dpkliem/wro-2022/dokumentation/Heckansicht.jpg

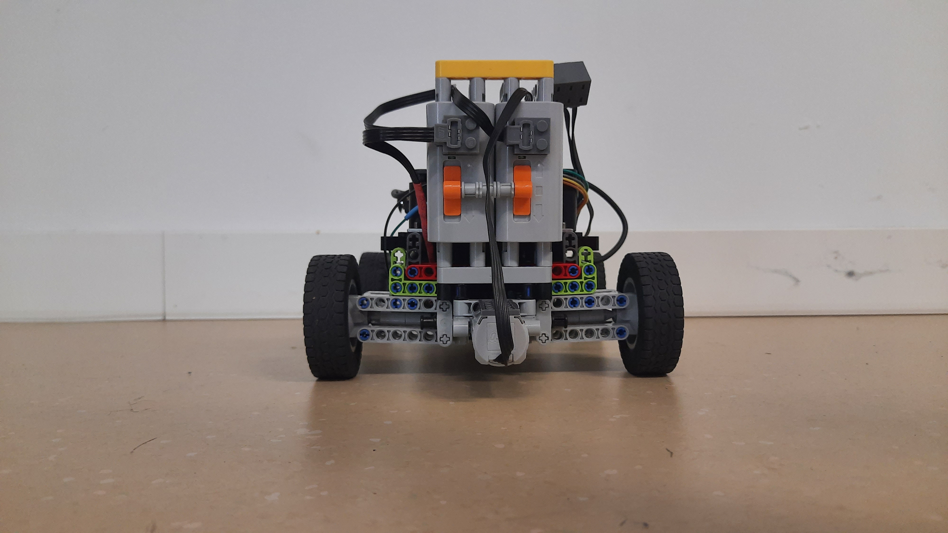
dokumentation/Heckansicht.jpg
