dpkliem/wro-2022/dokumentation/Seitenansicht_von_rechts_updated.jpeg

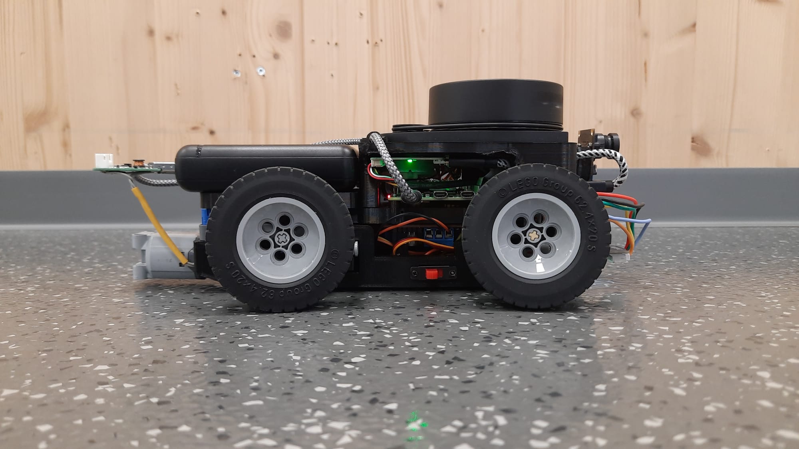
dokumentation/Seitenansicht_von_rechts_updated.jpeg
