dpkliem/wro-2022/README.md

Documentation
World Robot Olympiad – Future Engineers
Team Siemens Chemnitz
Bei YouTube haben wir eine nicht gelistete Playlist erstellt. Darin ist ein Video, in dem unser Auto das Eröffnungsrennen fährt und ein Video, in dem unser Auto das Hindernisrennen meistert, enthalten. Hier geht es zu Playlist: https://youtube.com/playlist?list=PLosNMtmjerQhduPas9dO_IPUJpvwRk50k.
Als Kleincomputer verwenden wir einen Raspberry Pi 4B. An diesem ist die gesamte Sensorik (Kamera, Schalter und Farbsensor) und Aktorik (Servomotor und Antriebsmotor mit Motortreiber) angeschlossen. Der Raspberry Pi wird über eine Powerbank mit 5V Betriebsspannung versorgt. Die Sensorik bezieht ihre Spannung vom Raspberry Pi. Der Servomotor hat eine eigene Spannungsversorgung von 6V. Der Antriebsmotor hat ebenfalls eine eigene Spannungsversorgung von 9V. Um den Antriebsmotor anzusteuern, befindet sich zwischen Raspberry Pi und Antriebsmotor ein Motortreiber.
Einrichtung des Raspberry Pi’s: Zuerst wird auf dem Kleincomputer das Betriebssystem Debian Buster installiert. Dies wird von einem externen Computer auf die SD-Karte des Kleincomputers geschrieben. Um weitere Schritte durchzuführen, verbindet man den Raspberry Pi über ein WLAN-Netzwerk mit einem externen Computer. Dazu greift man mittels dem Programm 'Remotedesktopverbindung' (unter Windows) von einem externen Computer auf den Kleincomputer zu. Alternativ kann der Raspberry Pi auch über HDMI Kabel mit einem Monitor verbunden werden, dann muss allerdings noch Maus und Tastatur an die USB-Ports des Kleincomputers angeschlossen werden. Jetzt muss in den Einstellungen der Kamerazugriff erlaubt werden. Da wir in unserem Programm auf Bibliotheken zurückgreifen, müssen diese jetzt installiert werden, um unser Programm nutzen zu können. Es muss 'OpenCV' installiert werden, eine genauere Anleitung findet man unter folgendem Link: https://singleboardbytes.com/647/install-opencv-raspberry-pi-4.html. Des Weiteren muss die Bibliothek 'gpiozero' installiert werden. Eine genauere Anleitung findet man unter folgendem Link: https://gpiozero.readthedocs.io/en/stable/installing.html. Außerdem muss auch noch die Bibliothek 'NumPy' aufgespielt werden, sowie die Bibliothek 'pigpio'. Hilfestellungen hierzu erhält man unter folgenden beiden Links: https://numpy.org/install/ und https://abyz.me.uk/rpi/pigpio/download.html. Zuletzt muss noch die Bibliothek 'Adafruit TCS34725 Library' installiert werden um den Farbsensor nutzen zu können. Die Anleitung findet sich unter folgendem Link: https://learn.adafruit.com/adafruit-color-sensors/python-. Der Code kann nun in einer frei gewählten Programmierumgebung (wir nutzen VisualStudioCode) auf dem Raspberry Pi geöffnet und bearbeitet werden. Wenn man nun ausführen auswählt, wird der Code auf dem Steuergerät kompiliert und ausgeführt. Ein Hochladen entfällt, da direkt auf dem Steuergerät programmiert wird. 
Zum Code: Unser Programm startet, wenn zwei Kontakte mit einem Schalter verbunden werden. Nun wird der Motor gestartet. Jetzt nimmt die Kamera ein Frame auf. Dieses dreht nun unsere Software und schneidet die obere Hälfte weg. Nun wird das Bild in ein HSV-Farbmodell umgewandelt. Über eine Funktion werden jetzt drei Bilder erstellt. Daher enthält das erste alle schwarzen, das zweite alle grünen und das letzte alle roten Flächen. Nun erkennt eine Funktion die untere Kante der Begrenzungen. Eine weitere Funktion erkennt die roten und grünen Objekte. Aus den erkannten Linien und Objekten wird nun die ideale Fahrtrichtung errechnet. Daraus wird der einzuschlagende Winkel des Servos errechnet und an diesen ausgegeben. Der Farbsensor detektiert nun die orange oder blaue Linie und zählt darüber die Runden. Nachdem er die dritte Runde gezählt hat, hält er nach einer gewissen Zeit (maximal 6 Sekunden) an.

UPDATE zum Deutschlandfinale:

Aufgrund der mangelnden Wendigkeit, die sich im regionalen Ausschied gezeigt hatte, wurde das Roboterauto von Grund auf erneuert. Um den Wendekreis zu verkleinern kann das Roboterauto nun mit beiden Achsen lenken. Die Lenkkonstruktion wurde hauptsächlich mit Lego umgesetzt. Um zusätzlich noch das Gewicht und die Abmaße des Roboterautos zu optimieren, ist der Großteil der konstruktiven Komponenten des Roboters mittels eines 3D-Druckers gedruckt wurden. Bei Fragen zu Material und Druckeinstellungen geben wir auf Nachfrage gerne Antwort. Die Dateien der einzelnen Bauteile befinden sich im entsprechenden Ordner. Zusätzlich wurde noch ein 3D-Modell des Roboters erstellt, welches jedoch aufgrund der Dateigröße nicht ins Repository hochgeladen werden konnte, auf Nachfrage aber zur Verfügung gestellt werden kann. Weiterhin wurde die Spannungsversorgung verbessert. Die drei Spannungsversorgungen, die im regionalen Ausscheid verwendet wurden, konnten mittels eines Step-up Converters, der die 5 Volt Ausgangsspannung der Powerbank in 12 Volt für den Motortreiber und den Motor umwandelt, auf eine einzige Spannungsversorgung reduziert werden. Die beiden vorher verwendeten Motoren wurden durch einen stärkeren Lego-Motor ersetzt. Ein weiteres Upgrade ist der Lidarsensor, welcher die Probleme mit der Lichtabhängigkeit des Bildverarbeitungsalgorithmus ausgleichen soll. Der Sensor erfasst in 360° alle Objekte, an denen der Laserstrahl reflektiert wird, und gibt die Polarkoordinaten bezüglich des Lidarsensors und die Distanz zurück. Das Konzept für den Algorithmus ist ähnlich dem Algorithmus für die Bildverarbeitung. Die Punktwolke, die der Lidarsensor ausgibt, wird durch den Algorithmus auf die Begrenzungslinien hin analysiert. Anhand der Neigung und der Lage der der Begrenzungen wird der Winkel für den Servo berechnet. Jedoch wird der Lidarsensor im Wettbewerb nicht verwendet, da aufgrund der kürze  der Zeit das Programm nicht ausreichend getestet und erprobt werden konnte.
