dpkliem/wro-2022/dokumentation/WRO_2022_Technische_Zeichnung.pdf

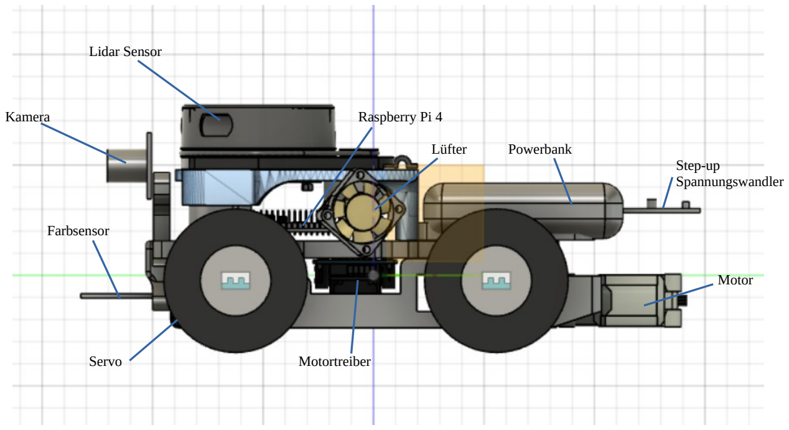
[picture p3: page 1]

Lidar Sensor

Kamera | Raspberry Pi 4
Lüfter | Powerbank
Step-up
Spannungswandler

Farbsensor

Motor

Servo | Motortreiber
