dpkliem/wro-2022/dokumentation/Ansicht_von_unten.jpg

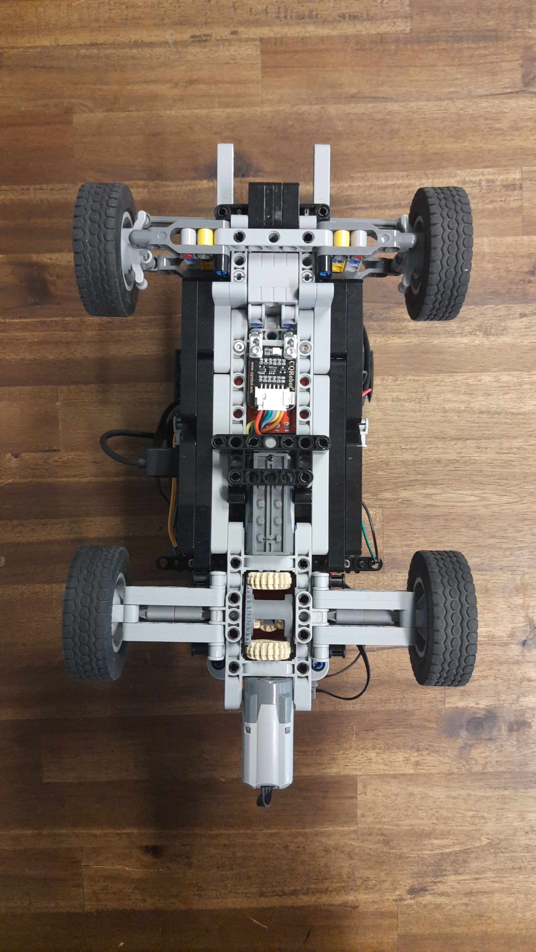
dokumentation/Ansicht_von_unten.jpg
