dpkliem/wro-2022/dokumentation/Ansicht_von_unten_updated.jpeg

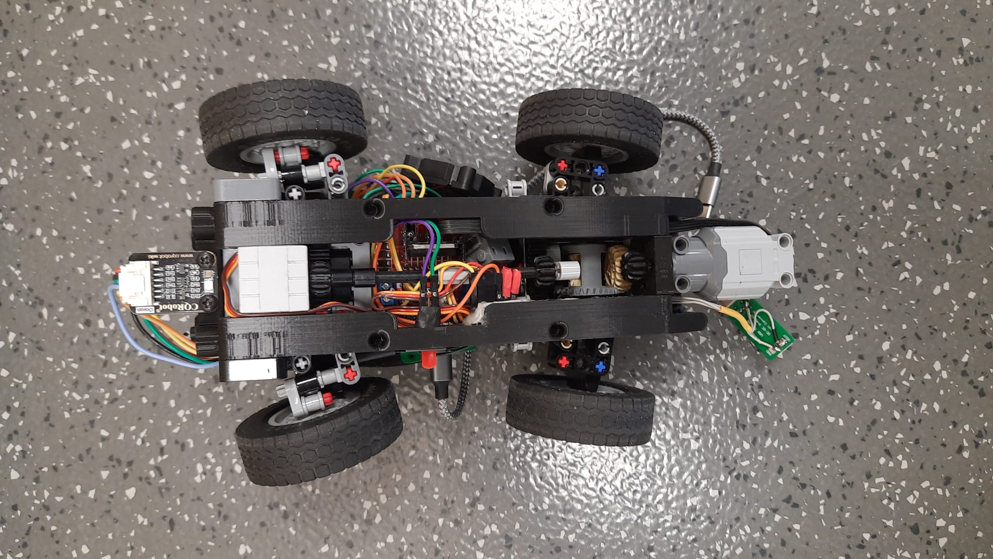
dokumentation/Ansicht_von_unten_updated.jpeg
