dpkliem/wro-2022/dokumentation/Draufsicht.jpg

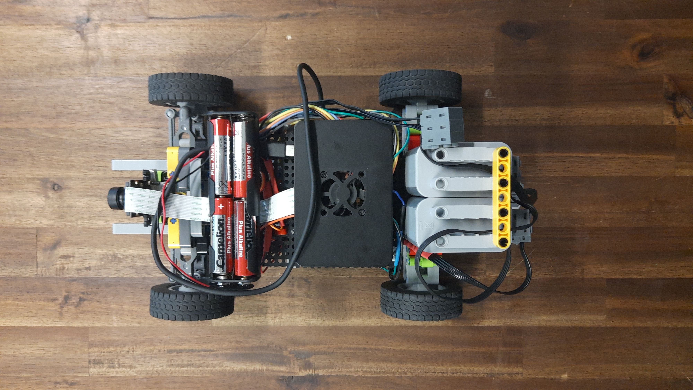
dokumentation/Draufsicht.jpg
