dpkliem/wro-2022/dokumentation/Draufsicht_updated.jpeg

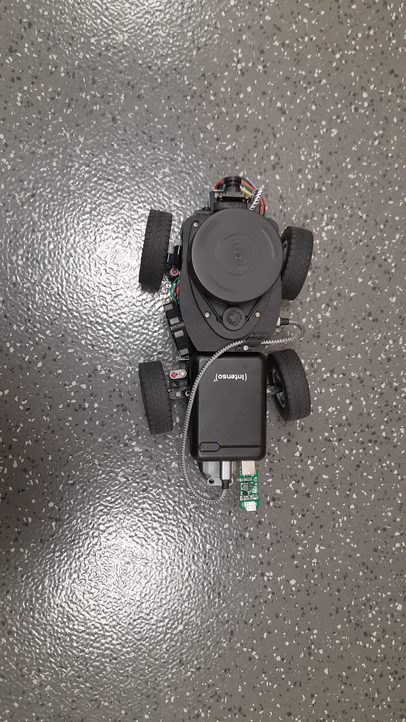
dokumentation/Draufsicht_updated.jpeg
