dpkliem/wro-2022/dokumentation/Frontansicht.jpg

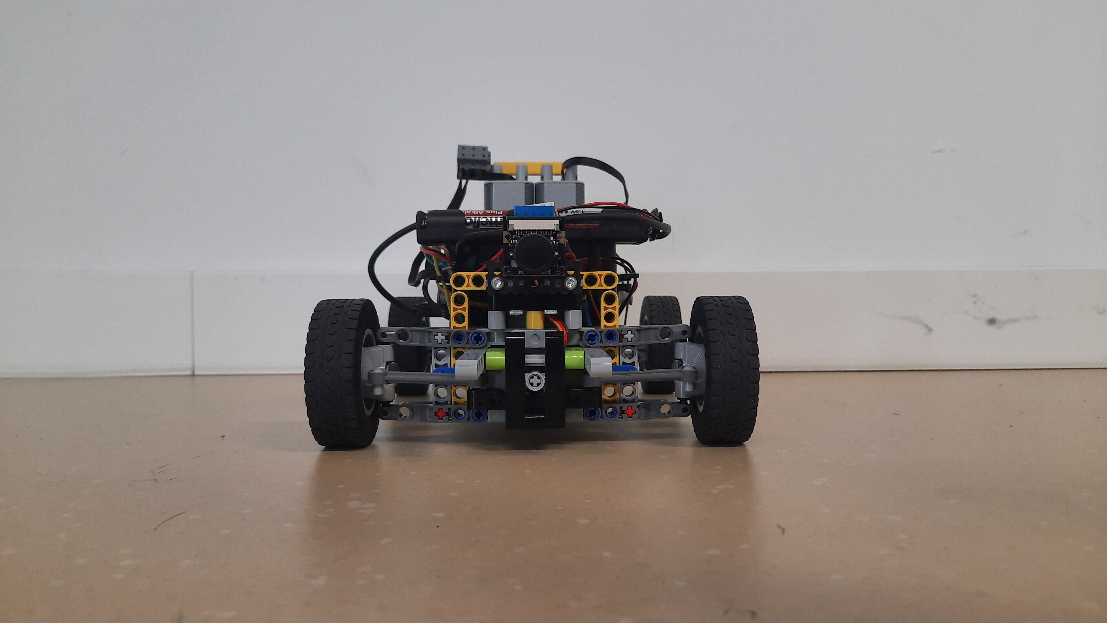
dokumentation/Frontansicht.jpg
