dpkliem/wro-2022/dokumentation/Frontansicht_updated.jpeg

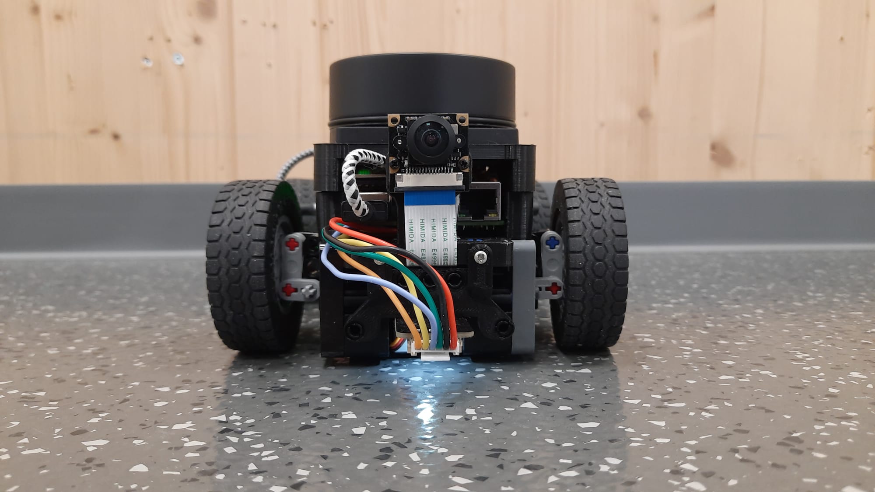
dokumentation/Frontansicht_updated.jpeg
