dpkliem/wro-2022/dokumentation/Heckansicht_updated.jpeg

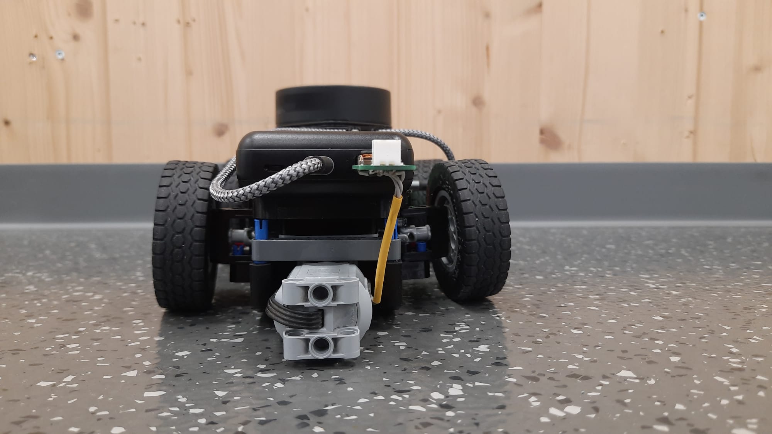
dokumentation/Heckansicht_updated.jpeg
