dpkliem/wro-2022/dokumentation/Seitenansicht_von_links.jpg

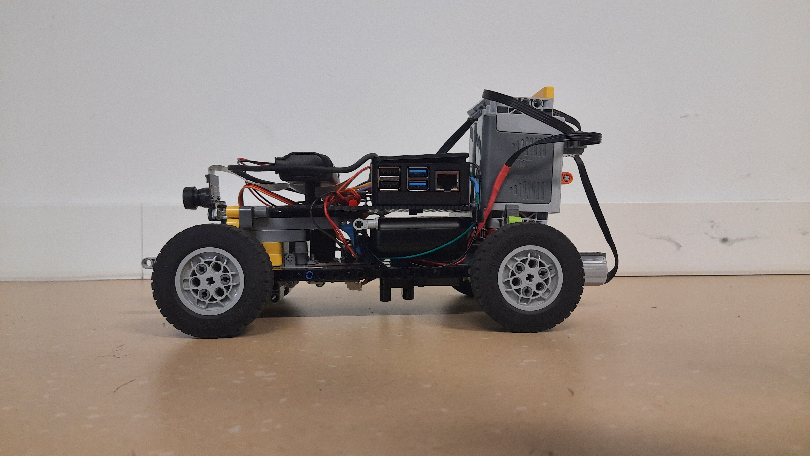
dokumentation/Seitenansicht_von_links.jpg
