dpkliem/wro-2022/dokumentation/Seitenansicht_von_links_updated.jpeg

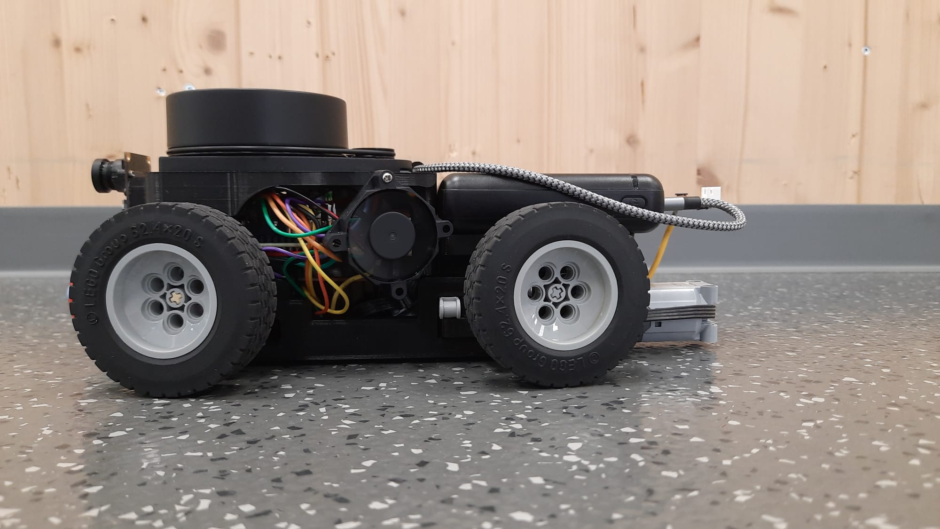
dokumentation/Seitenansicht_von_links_updated.jpeg
