dpkliem/wro-2022/dokumentation/Seitenansicht_von_rechts.jpg

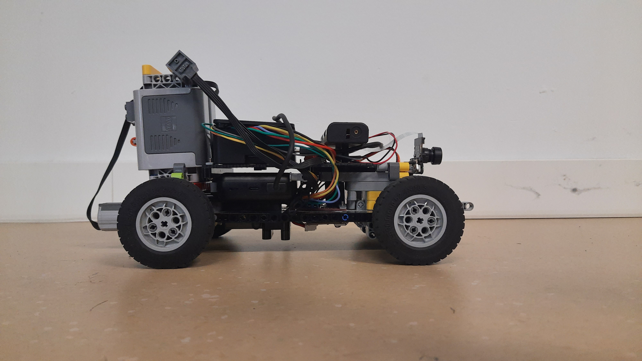
dokumentation/Seitenansicht_von_rechts.jpg
