dpkliem/wro-2022/3d_dateien/Motorhalterung.stl

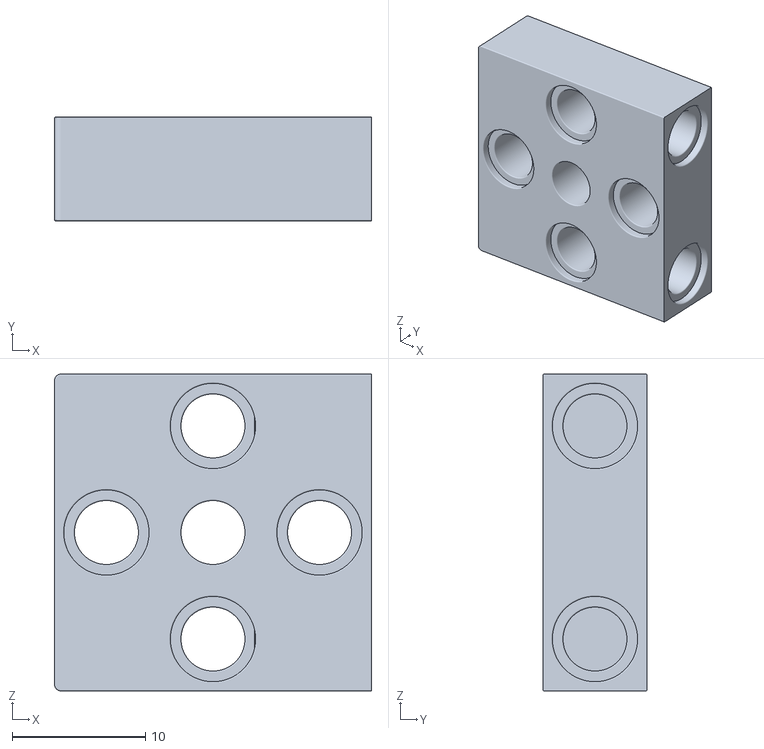
[picture p14: CAD file, 2022-09-13]
3d_dateien/Motorhalterung.stl
23.8 x 7.80 x 23.8
