dpkliem/wro-2022/3d_dateien/Träger Schalter.stl

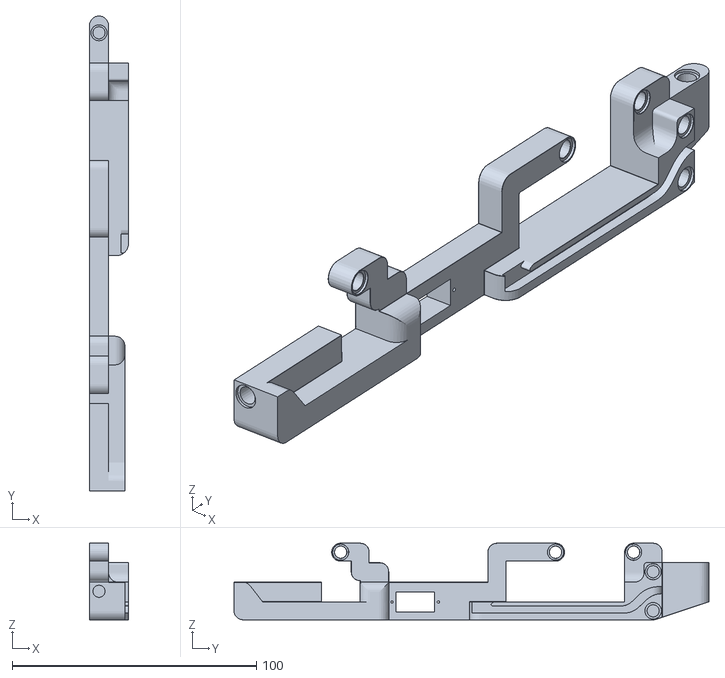
[picture p15: CAD file, 2022-09-13]
3d_dateien/Träger Schalter.stl
16.0 x 194.6 x 31.4
