dpkliem/wro-2022/3d_dateien/Kabelklemme.stl

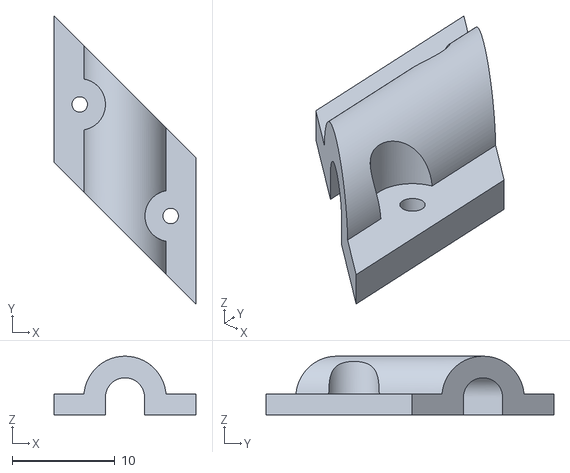
[picture p17: CAD file, 2022-09-13]
3d_dateien/Kabelklemme.stl
13.8 x 28.0 x 5.70
