dpkliem/wro-2022/3d_dateien/Lidarhalterung neu.stl

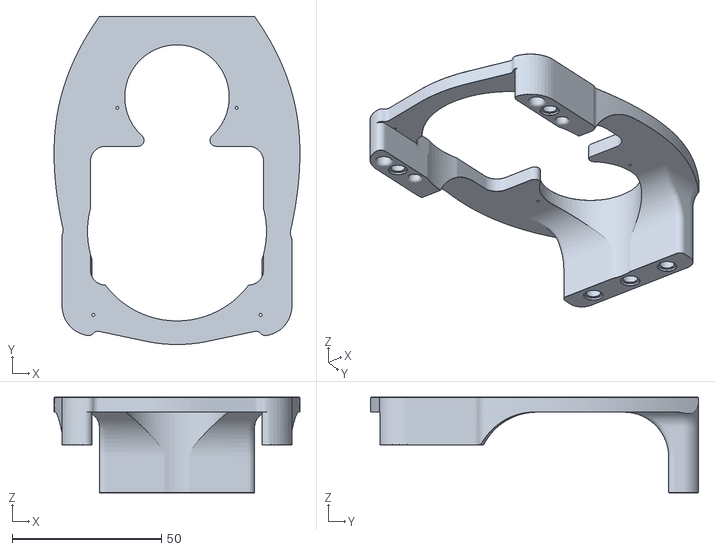
[picture p18: CAD file, 2022-09-13]
3d_dateien/Lidarhalterung neu.stl
82.4 x 109.9 x 32.0
