dpkliem/wro-2022/3d_dateien/Farbsensorhalterung.stl

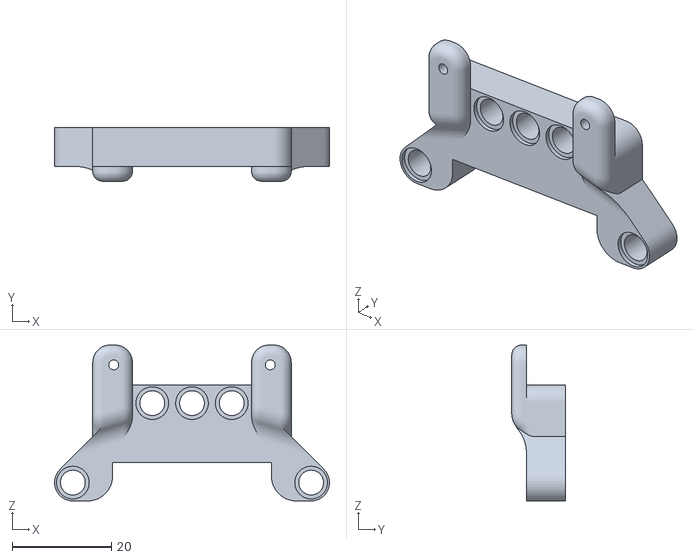
[picture p19: CAD file, 2022-09-13]
3d_dateien/Farbsensorhalterung.stl
55.4 x 10.8 x 31.4
