dpkliem/wro-2022/3d_dateien/Halterung Powerbank.stl

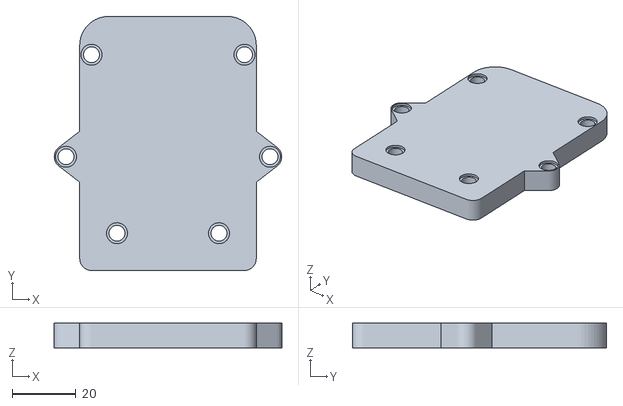
[picture p20: CAD file, 2022-09-13]
3d_dateien/Halterung Powerbank.stl
71.4 x 79.7 x 7.80
