dpkliem/wro-2022/dokumentation/WRO_2022_Schaltplan_updated.pdf

1 | 2 | 3 | 4 | 5 | 6 | 7 | 8 | 9 | 10 | 11 | 12 | 13 | 14 | 15 | 16 | 17

A

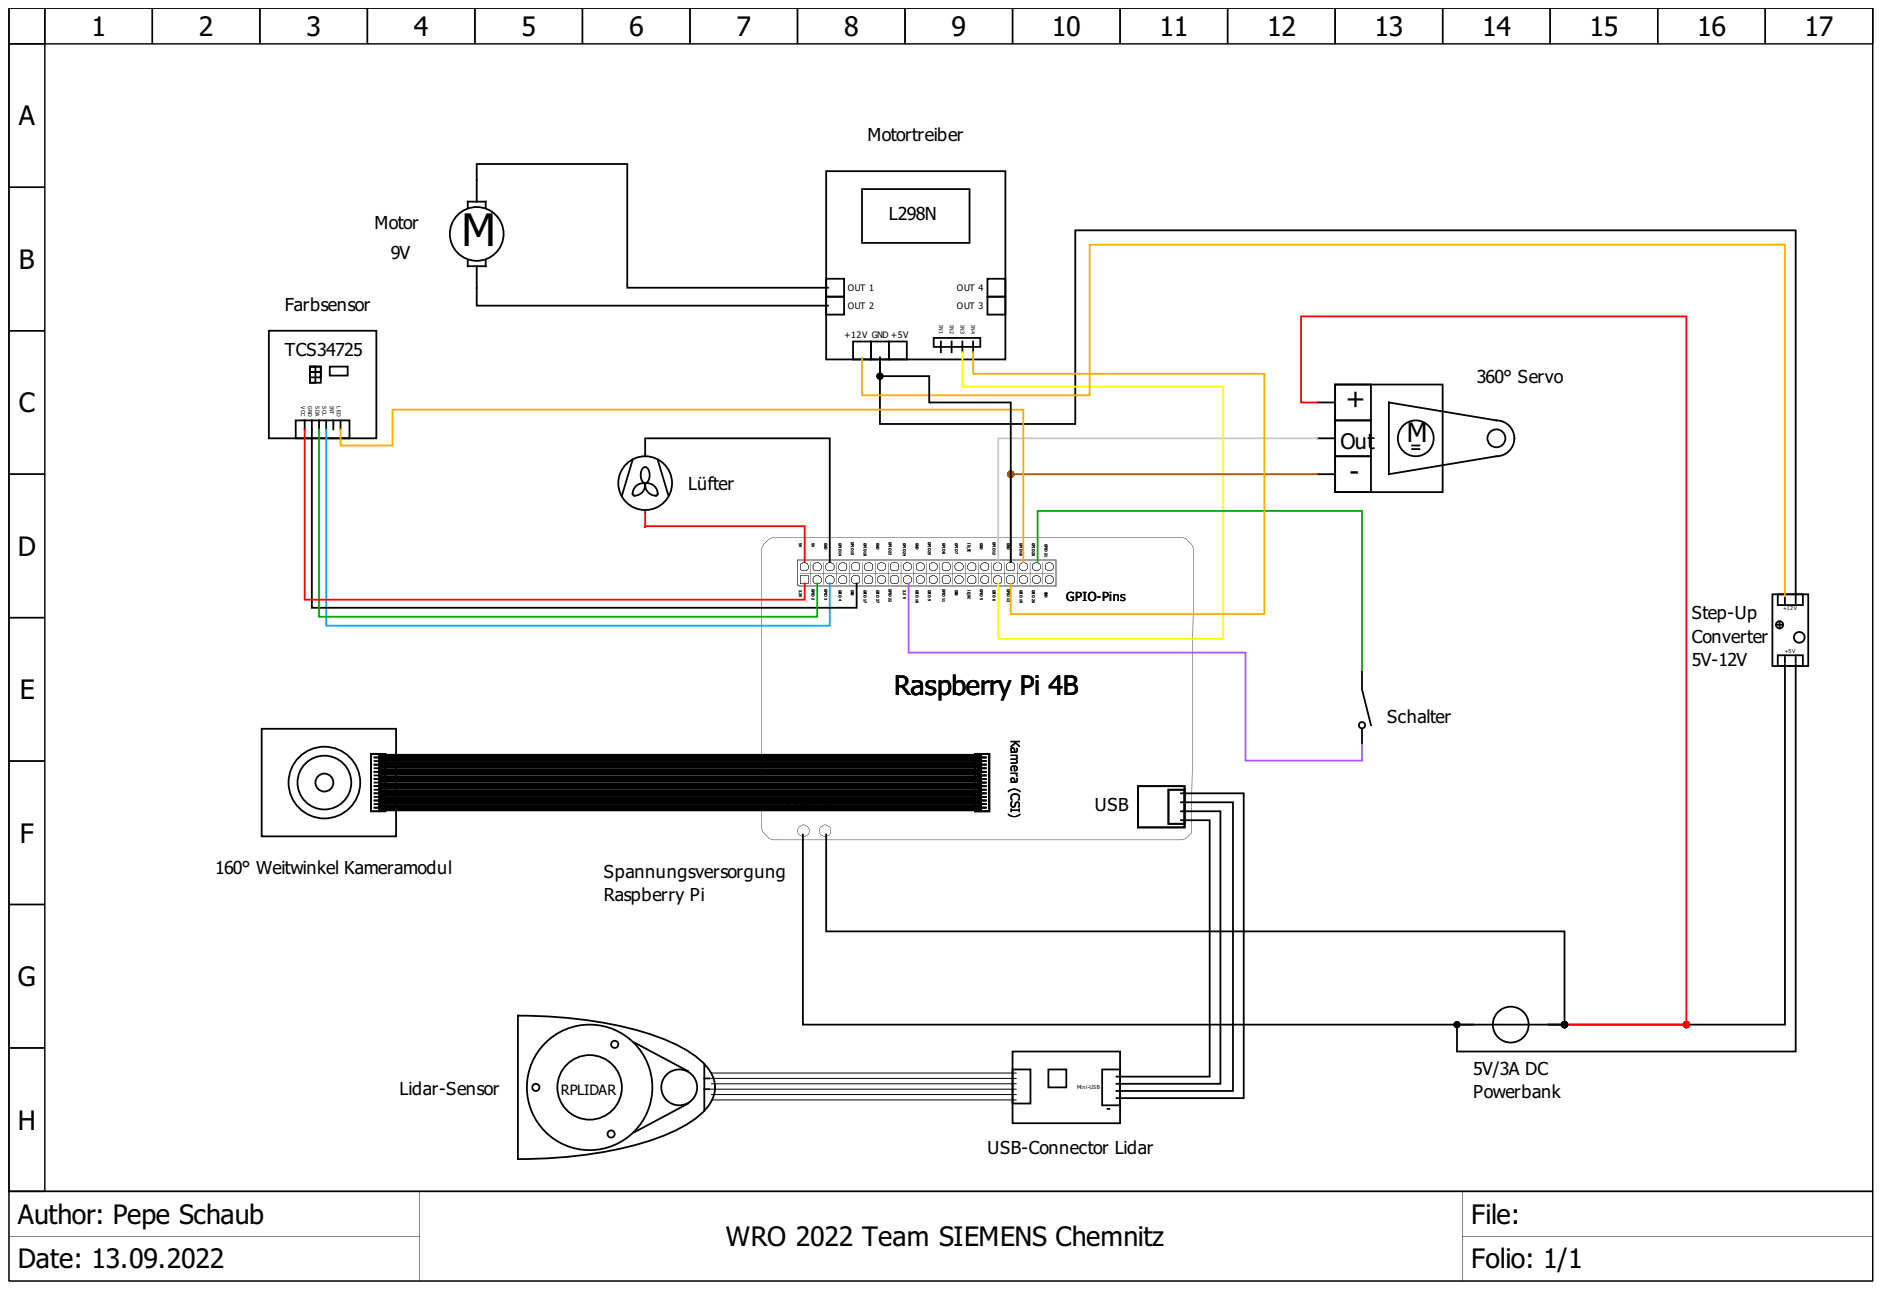
[picture p21: page 1]
Out -; OUT 4; GND; OUT 2; IN3 OUT 3; OUT 1; Raspberry Pi 4B; GPIO 12; GPIO 7; GPIO 11 GPIO 8; GPIO 26; GPIO 21; GPIO 18; GPIO 24; GPIO 27; GPIO 5; GPIO 6; GPIO 17; GPIO 23; GPIO 4; GPIO 9; GPIO 16; GPIO 19; 5V GPIO 2; GPIO 14; GPIO 20; GPIO 13 GND; GPIO 10; GPIO 25; GND GPIO 3; GPIO 22; GPIO 15; PWR_IN; GPIO-Pins; Kamera (CSI); GPIO 8; GPIO 11; GPIO 13; GPIO 3; GPIO 2; RPLIDAR; Mini-USB; INT; SDA; SCL; VCC; 160° Weitwinkel Kameramodul; Motor 9V; 5V/3A DC Powerbank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

USB-Connector Lidar

Author: Pepe Schaub | WRO 2022 Team SIEMENS Chemnitz | File:
Date: 13.09.2022 | | Folio: 1/1
