dpkliem/wro-2022/dokumentation/WRO_2022_Schaltplan.pdf

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

A

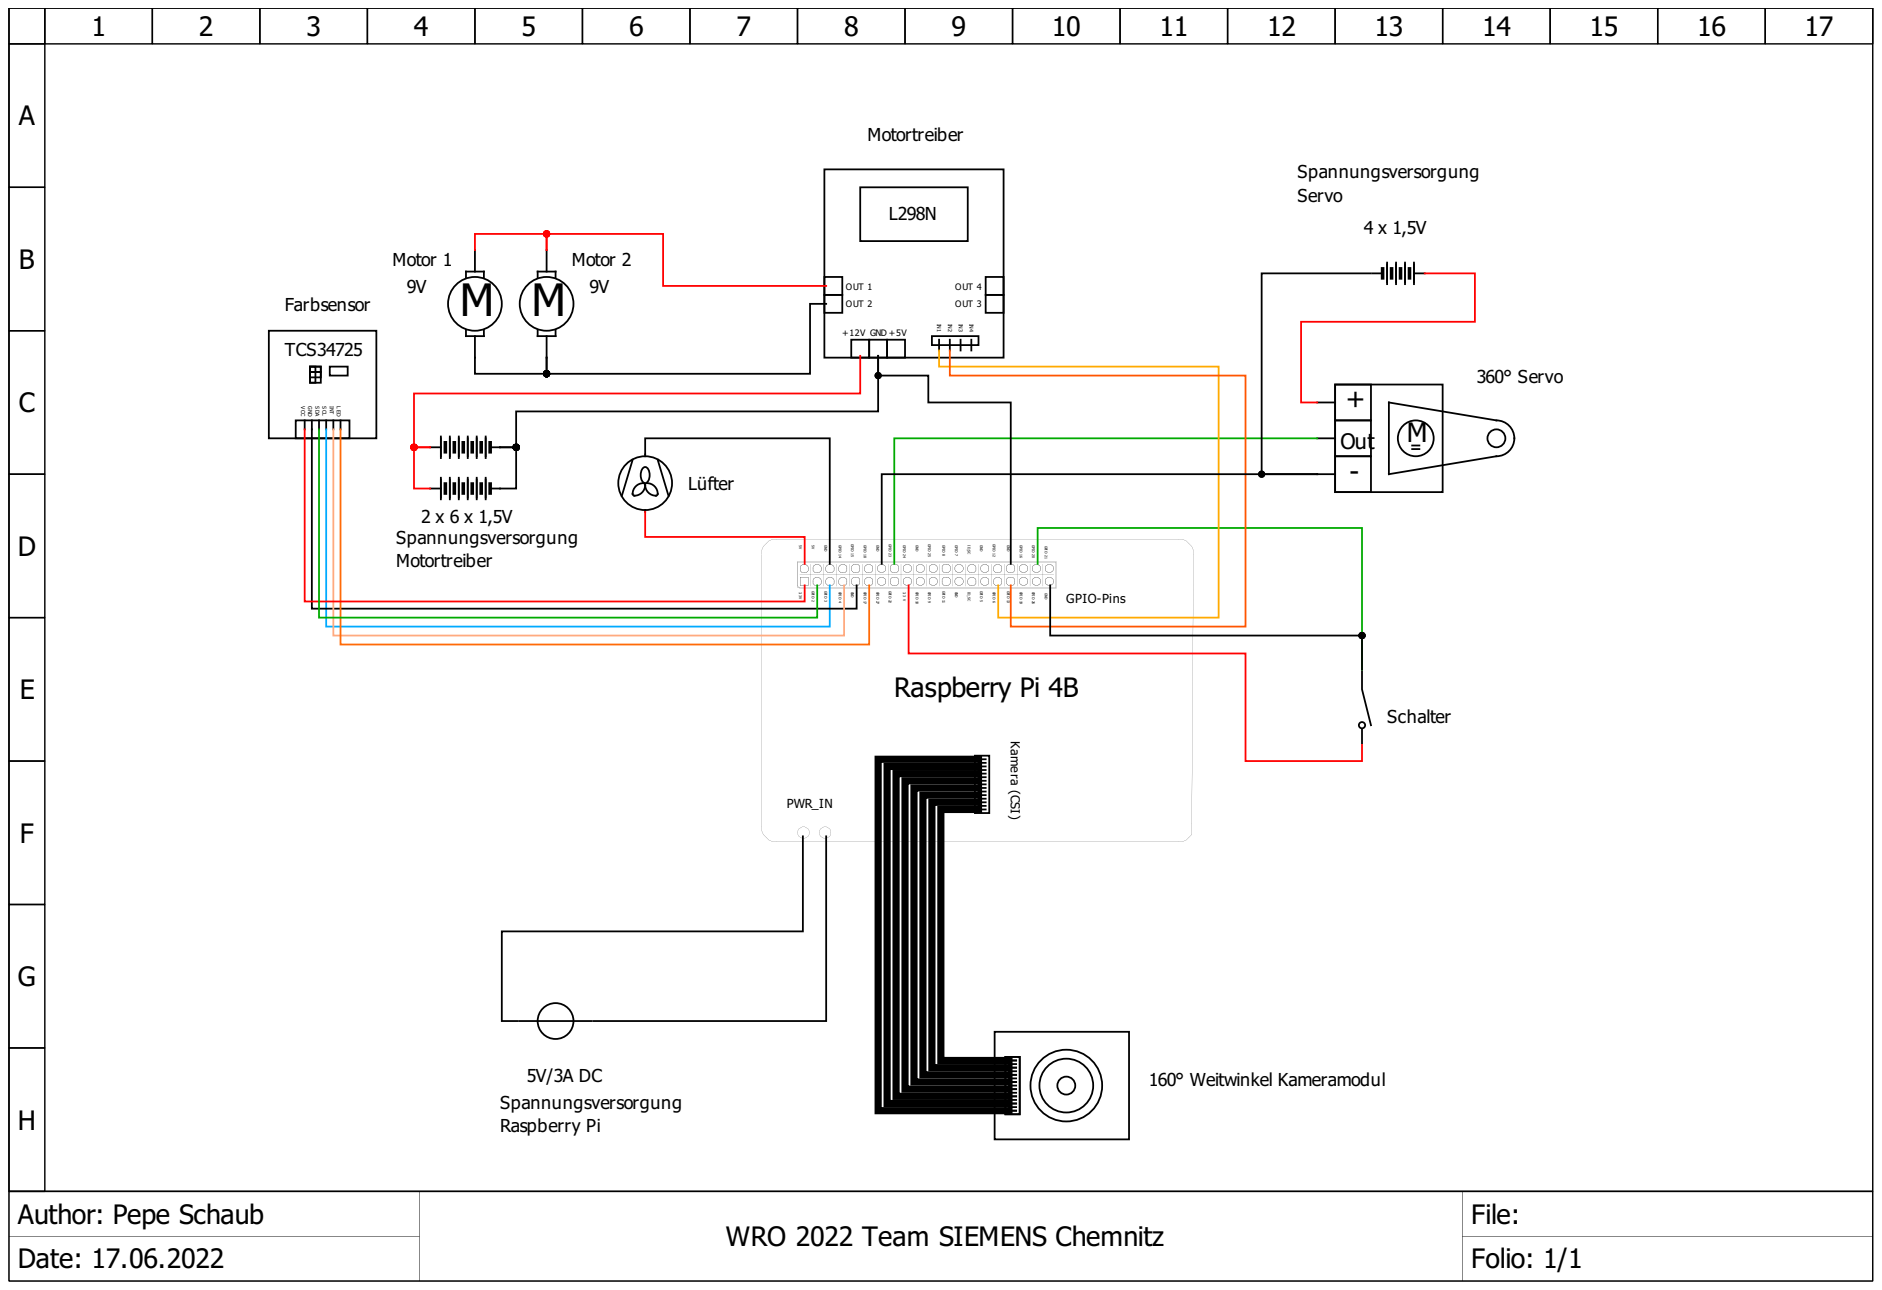
[picture p22: page 1]
INT; GND; SDA; SCL; VCC; Raspberry Pi 4B; GPIO 12; GPIO 7; GPIO 11 GPIO 8; GPIO 26; GPIO 21; GPIO 18; GPIO 24; GPIO 27; GPIO 5; GPIO 6; GPIO 17; GPIO 23; GPIO 4; GPIO 9; GPIO 16; GPIO 19; 5V GPIO 2; GPIO 14; GPIO 20; GPIO 13 GND; GPIO 10; GPIO 25; GND GPIO 3; GPIO 22; GPIO 15; PWR_IN; GPIO-Pins; Kamera (CSI); OUT 4; OUT 2; IN3 OUT 3; OUT 1; Out -; Schalter; Farbsensor; Lüfter; Motortreiber; Spannungsversorgung Servo; Motor 2; 360° Servo; Motor 1; TCS34725; 160° Weitwinkel Kameramodul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

Author: Pepe Schaub | WRO 2022 Team SIEMENS Chemnitz | File:
Date: 17.06.2022 | | Folio: 1/1
